HamedJason/ProyectoDeCarrera/docs/diagramas/diagrama_bd.png

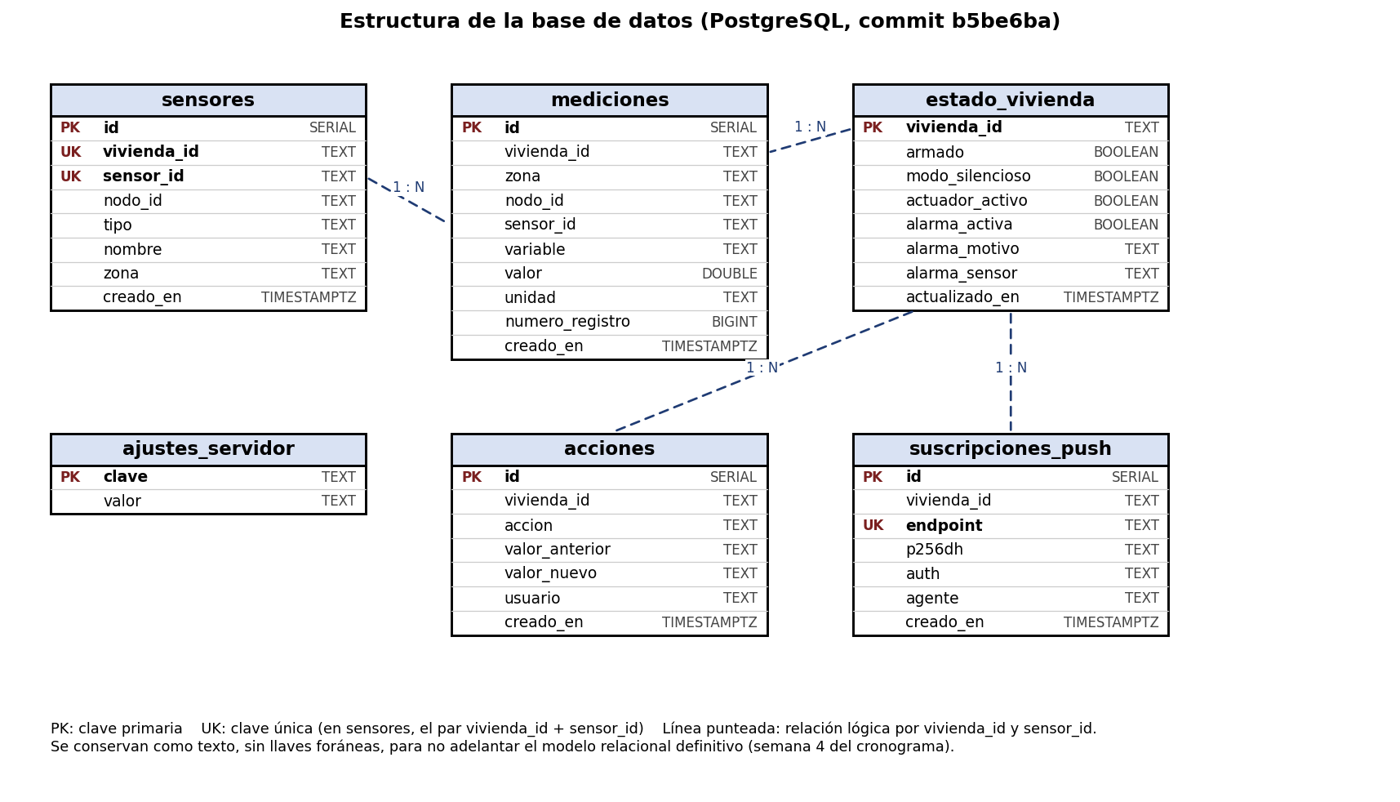
docs/diagramas/diagrama_bd.png
