HamedJason/ProyectoDeCarrera/docs/diagramas/diagrama_conexion.png

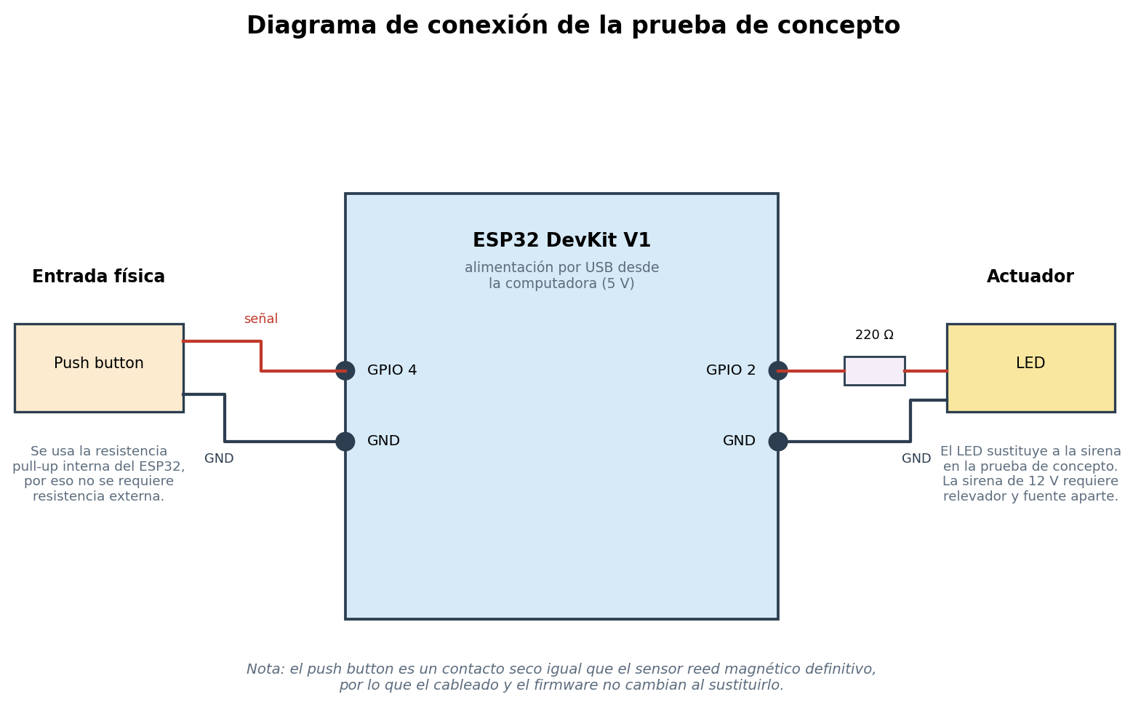
docs/diagramas/diagrama_conexion.png
