HamedJason/ProyectoDeCarrera/docs/diagramas/diagrama_flujo.png

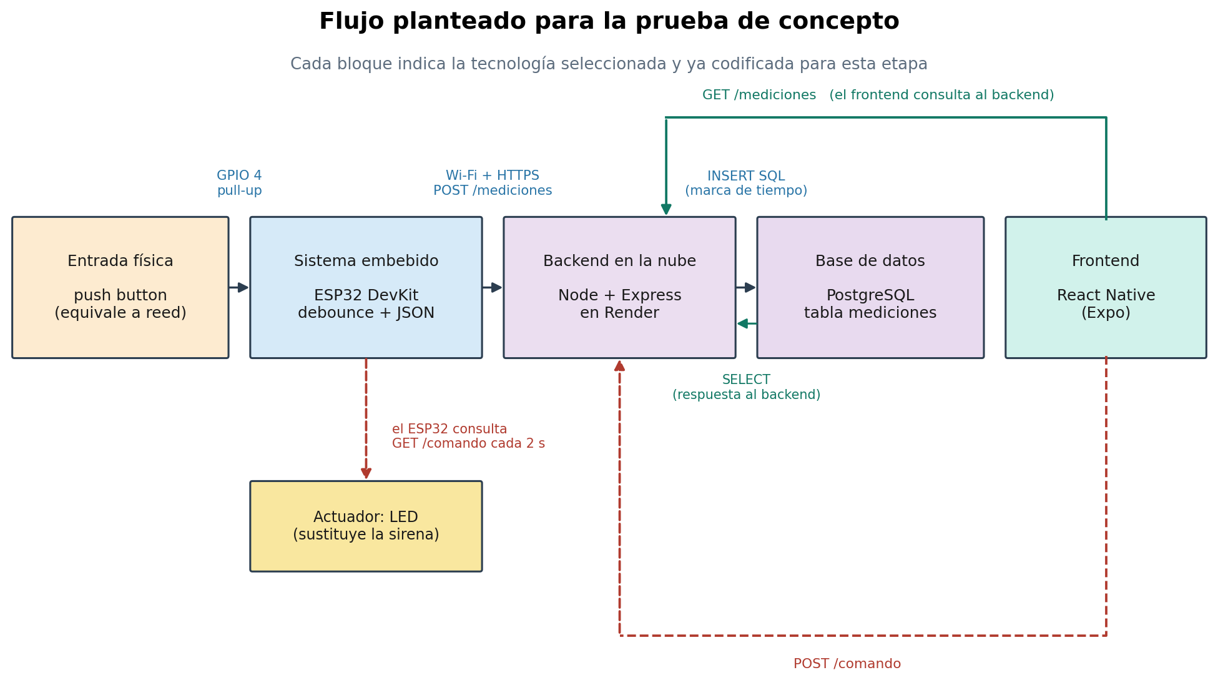
docs/diagramas/diagrama_flujo.png
