HamedJason/ProyectoDeCarrera/proteus/Taller9.PDF

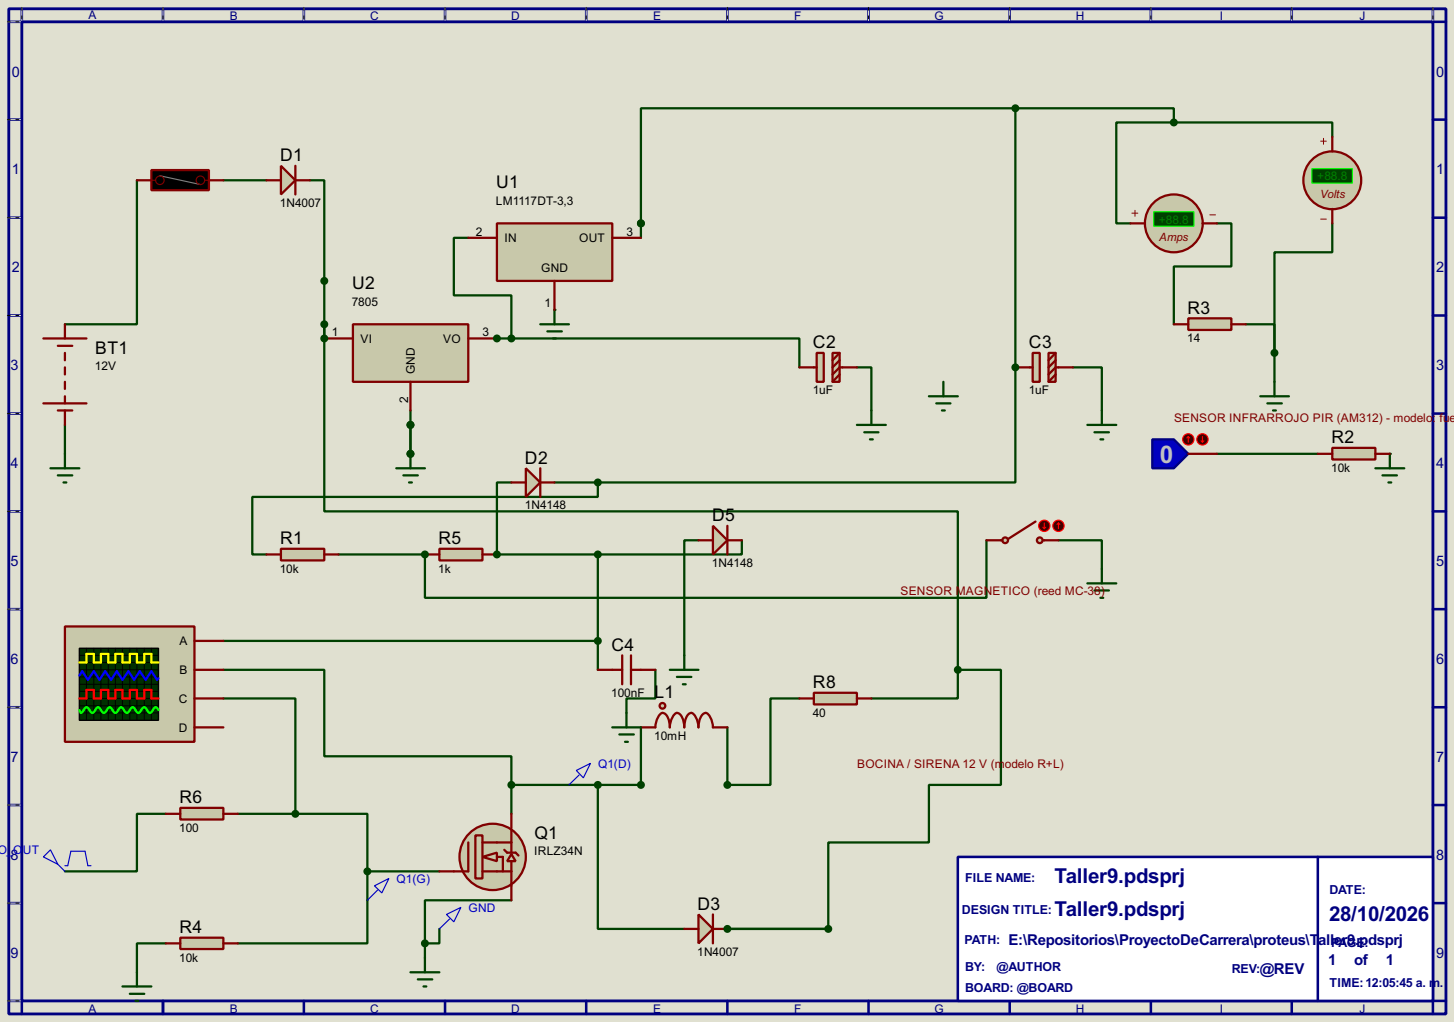
[picture p34: page 1]

SENSOR INFRARROJO PIR (AM312) - modelo: fuente 0/3.3 V

SENSOR MAGNETICO (reed MC-38)

PATH: E:\Repositorios\ProyectoDeCarrera\proteus\Taller9.pdsprj
