HamedJason/ProyectoDeCarrera/(list of files, drawings)

Other design files:
proteus/Project Backups/Taller9 [20261021, 13-35-35].pdsprj
proteus/Project Backups/Taller9 [20261021, 13-38-41].pdsprj
proteus/Project Backups/Taller9 [20261021, 13-40-13].pdsprj
proteus/Project Backups/Taller9 [20261021, 13-58-18].pdsprj
proteus/Project Backups/Taller9 [20261027, 23-30-38].pdsprj
proteus/Project Backups/Taller9 [20261027, 23-39-45].pdsprj
proteus/Project Backups/Taller9 [20261027, 23-48-55].pdsprj
proteus/Project Backups/Taller9 [20261028, 00-03-20].pdsprj
proteus/Project Backups/Taller9 [20261028, 00-05-45].pdsprj
proteus/Project Backups/Taller9 [20261028, 01-38-12].pdsprj
proteus/Taller9.pdsprj
