HamedJason/ProyectoDeCarrera/(commit log)

2026-09-30 Prototipo funcional: backend, webapp y firmware del nodo sensor
2026-09-30 Agrega alarma con apagado desde la app, LED intermitente y puerto configurable
    Backend:
    - Nuevo campo alarma_activa en estado_vivienda (migracion con ALTER TABLE)
    - POST /alarma para que el nodo avise inicio y fin de la alarma (con token)
    - POST /estado acepta alarma_activa=false para apagarla desde la app
    - Desarmar el sistema apaga la alarma
    - Bitacora de alarma_activada, alarma_terminada y apagar_alarma
    Webapp:
    - Tarjeta ALARMA ACTIVA con boton Apagar alarma
    - Tarjetas de estado de puerta y movimiento
    Firmware:
    - La salida parpadea para simular la sirena
    - Se apaga desde la app, al desarmar o a los 30 s
    - PIR con 45 s de estabilizacion y pull-down interno
    Despliegue:
    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
2026-09-30 Agrega notificaciones push, avisos en la app y limpieza de historial de pruebas
    - Notificaciones push por ntfy cuando se activa la alarma, y tambien cuando
    dispara en modo silencioso (sin sirena). Configurable con NTFY_TOPIC
    - Motivo de la alarma (alarma_motivo) visible en la app y en el aviso
    - POST /limpiar borra el historial, solo con MODO_PRUEBAS=true
    - GET /configuracion informa a la app que funciones estan habilitadas
    - Avisos en el dispositivo: vibracion, sonido, notificacion del navegador
    cuando hay conexion segura, y titulo parpadeante
    - Boton de borrar historial con doble confirmacion, visible solo en pruebas
    - El nodo envia motivo y zona al avisar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
2026-09-30 Mueve el sensor PIR al GPIO 18
    El GPIO 5 es un pin de arranque (strapping) del ESP32 y daba lecturas falsas
    con el AM312. Se confirmo con un sketch de prueba que en el GPIO 18 el sensor
    responde correctamente. Se actualiza el firmware y la guia de cableado.
    [nodo_sensor.ino]
2026-09-30 Detecta el PIR con interrupcion y muestra el pin en el Serial
    El AM312 mantiene su salida en alto solo unos 2 segundos. Con el sondeo, una
    peticion HTTP lenta podia hacer que el ciclo perdiera el pulso. Ahora el flanco
    de subida se captura con una interrupcion. Ademas el arranque muestra el GPIO de
    cada sensor y cada pulso se imprime, para poder diagnosticar sin ambiguedad.
2026-09-30 Rediseña la webapp con el plano de la casa como elemento central
    La casa se dibuja como un plano en planta y el plano es la interfaz: los muros
    indican si el sistema esta armado (solido) o desarmado (punteado), la hoja de la
    puerta se abre cuando el contacto se separa, y el cono del sensor se enciende
    cuando hay movimiento. El rojo se reserva para la alarma, el ambar para la
    actividad y el verde pino para el armado.
    - Historial como linea de tiempo que une eventos de sensores y acciones
    - Tipografia Bricolage Grotesque (OFL) autoalojada, funciona sin Internet y sobre HTTP
    - Distribucion de dos columnas en escritorio
    - Interruptores accesibles (role switch), foco visible y movimiento reduci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
2026-09-30 Varios sensores: puertas, ventanas y movimiento con tarjetas animadas
    - Backend: tabla sensores, endpoints /sensores, alarma_sensor, alta automatica
    - Firmware: tablas de contactos y PIR, una interrupcion por PIR
    - Webapp: tarjetas animadas por sensor, edicion de tipo y nombre, sirena animada
2026-09-30 PIR: entrada simple y deteccion por sondeo como respaldo de la interrupcion
2026-09-30 Puerta: la hoja no sobrepasa el piso y se ve una noche con luna y casas
2026-09-30 Nodo periferico ESP32-C3 por ESP-NOW y receptor en el ESP32
    - nodo_c3: contacto MC-38 y PIR, busqueda automatica de canal, cola y reintentos
    - nodo_sensor: recibe por ESP-NOW, deduplica, usa el nodo_id de cada origen
    - Sensores locales del receptor opcionales (USAR_SENSORES_LOCALES)
    - PASOS.md: conexiones y puesta en marcha
2026-09-30 Receptor: el ciclo principal atiende los paquetes ESP-NOW recibidos
2026-09-30 Receptor: tipos del protocolo antes de las funciones para los prototipos del Arduino IDE
2026-09-30 Lee la MAC directo del chip para evitar 00:00:00:00:00:00
2026-09-30 Notificaciones push propias (Web Push) sin depender de ntfy
    - Backend: claves VAPID generadas y guardadas en la base, tablas
    suscripciones_push y ajustes_servidor, endpoints /push/clave,
    /push/suscribir, /push/cancelar y /push/prueba. La alarma envia push a
    todos los dispositivos suscritos; ntfy queda como opcional.
    - Webapp: service worker sw.js, suscripcion desde el interruptor de avisos,
    aviso cuando iOS requiere agregar la app a inicio, boton de prueba.
2026-09-30 C3: soporta varios contactos magneticos (puerta, ventana, etc.)
    Tabla CONTACTOS con id, zona y pin; por omision puerta en GPIO 4 y
    ventana en GPIO 3. Cada contacto con su propio antirrebote, evento y
    latido. Cola de eventos ampliada a 16.
2026-10-05 Cuentas, varias viviendas, registro automatico de sensores y camara OV5640
    - Inicio de sesion (scrypt, cookie de sesion, invitaciones), viviendas y miembros
    - Token de dispositivo por vivienda (compatible con el token global)
    - Latido por lotes: sensores y nodos se descubren solos; alertas de hub/nodo sin senal
    - Camara: tareas por long-poll, fotos en rafaga, vista en vivo con topes, retencion en disco
    - Firmware: hub con latidos/token, C3 con IDs desde la MAC, nuevo camara_ov5640
2026-10-06 Despliegue en VPS con red del proxy, medicion de push y simulador de pruebas
    - docker-compose.proxy.yml + desplegar_vps.sh: conecta el backend a ochil_edge y verifica
    - Push: medicion de entrega extremo a extremo (/push/recibido) y retraso del hub en el log
    - Hub: avisa la alarma antes de subir la medicion y desactiva el ahorro de energia del Wi-Fi
    - pruebas/simular.js y PRUEBAS.md para probar servidor, hub, C3 y camara
2026-10-06 Script de pruebas minimas, lista de evidencias y diagrama de la base de datos
2026-10-06 Historial desplegable, push con foto, HTTPS opcional y cifrado ESP-NOW multi-nodo
    - App: el historial muestra 5 eventos y se despliega bajo demanda.
    - Backend: aviso push con la primera foto de la alarma (URL firmada, 15 min).
    - Firmware: HTTPS opcional (hub y camara) con raiz ISRG y NTP; el hub cifra
    ESP-NOW con una lista de MACs de nodos C3 y descarta las no registradas.
    - Documentacion de puesta en marcha y de pruebas actualizada.
2026-10-06 Mover el proyecto a la raiz del repositorio y agregar los talleres en docs/talleres
    Todo el contenido de poc-alarma/ pasa a la raiz (git mv, se conserva el historial).
    Se actualizan las rutas de README.md y PASOS.md, y generar_diagramas.py guarda
    junto al propio script. Se agregan los talleres 4, 5, 6 y 7 en Word.
2026-10-07 Receptor: macPermitida despues de los tipos para que compile en el Arduino IDE
2026-10-14 Configuracion por comandos seriales y emparejamiento automatico de los C3
2026-10-21 Puente de camara con el ESP32-S3
2026-10-21 Deteccion de personas y movimientos por ONVIF
2026-10-21 Fix ONVIF que fallaba
2026-10-21 ONVIF: reintentar esperas cortadas por la camara
2026-10-21 Fix token de camara
2026-10-21 Agregada deteccion de personas y movimiento a la app con fotos)
2026-10-21 Ajuste FPS camara y cambio de su interfaz
2026-10-21 Prueba de tunel de la camara
2026-10-28 optimizaciones de uso de bateria del c3 con un solo sensor (deep-sleep y revisiones de cuando se arma/desarma la casa)
2026-10-28 agregado el taller 9 y actualizacion del 10 para incluir modificaciones en ahoro de bateria
2026-10-29 Migrar la interfaz web a Vue 3 con componentes
    Reemplaza el index.html monolitico por un proyecto Vite en frontend-web/
    (componentes .vue, stores, utilidades y CSS separado por area). La salida
    compilada queda en backend/publico, asi el despliegue no necesita Node.
2026-10-29 Endurecer la seguridad: cifrado y firma ESP-NOW, CORS y HSTS
    - Firmware: llave por instalacion guardada en flash (comando llave), PMK y
    LMK por nodo derivadas, firma HMAC-SHA256 de 8 bytes por paquete,
    respuesta de armado dirigida y con eco de secuencia, anti-replay estricto
    y contador de arranques en el C3.
    - Backend: CORS cerrado salvo CORS_ORIGEN, aviso si NTFY_TOPIC es corto.
    - Caddy: encabezado Strict-Transport-Security.
    Incluye tambien los cambios previos sin commitear de nodo_c3.ino.
2026-10-29 Rediseño de la interfaz con modo oscuro y panel lateral
    Agrego el panel de cuenta con selector de tema y la opción de reducir
    animaciones, el haz rojo giratorio cuando suena la alarma y el nombre
    Sentinel Home en toda la interfaz. Corrijo contrastes, evito que las
    consultas se encimen y dejo de devolver el texto interno de los errores
    fuera de MODO_PRUEBAS. Incluye DESIGN.md.
2026-10-29 Limpio comentarios del código
    Quito los comentarios que repetían el código y los separadores
    decorativos, y corrijo notas desactualizadas en docker-compose y
    schema.sql. No cambia el comportamiento.
